makersmakingchange/Rumble-Plate-Dice-Roller/README.md

# Rumble Plate Dice Roller
A switch adapted device to roll the dice for any game night!

This switch activated dice roller utilizes a hobby motor, battery holder, Omron switch, and 3.5mm jack along with a couple 3d printed parts and a clear plastic cup to make any dice game more accessible. This device is a new development of the Dice Spinner that features faster dice rolling and variations in allowable cup size.

The Rumble Plate Dice Roller allows for approximately 10oz to 22oz clear plastic cups. Following the assembly guide, the components can be wired and mounted, then the dice roller is all ready to use! It is an easy toy to make that allows people to roll the dice in an alternative way.

## Usage

An AT switch can be plugged into the 3.5mm jack on the side of the device to be used for activation. Alternatively, the on-device switch can be used for activation. The on-device button would be meant more for others playing around the table who are able to reach over and wrap their hands around the base to push the button. With the additional print of the vertical push base, the on-device button can be used to turn the device itself into the activation button such that anyone around the table can push on to top of  the clear cup to roll the dice. This on-device button can be used in tandem with the corded AT switch.

## Required Skills:

 - Soldering
 - 3D Printing

## Required Components

 - Motor
 - AAA Battery Holder
 - Velcro
 - Omron Switch
 - 3.5mm Jack
 - Clear Plastic Cup
 - Dice
 - 3D Printed Parts

## Printing Instructions

- Print the STL files in their given orientations
- 0.3 mm Layer height
- No supports
- No brim

## Build Instructions

This device consists of several 3D printed components and electrical components that assemble together and can be used in tandem with an assistive switch. All STL’s and documentation can be found in the downloadable maker files in the GitHub Repository.

<!-- ABOUT MMC START -->
## About Makers Making Change
[Makers Making Change Logo](https://www.makersmakingchange.com/)

Makers Making Change is a program of [Neil Squire](https://www.neilsquire.ca/), a Canadian non-profit that uses technology, knowledge, and passion to empower people with disabilities.

Makers Making Change leverages the capacity of community based Makers, Disability Professionals and Volunteers to develop and deliver affordable Open Source Assistive Technologies.

 - Website: [www.MakersMakingChange.com](https://www.makersmakingchange.com/)
 - GitHub: [makersmakingchange](https://github.com/makersmakingchange)
 - Bluesky: [@makersmakingchange.bsky.social](https://bsky.app/profile/makersmakingchange.bsky.social)
 - Instagram: [@makersmakingchange](https://www.instagram.com/makersmakingchange)
 - Facebook: [makersmakechange](https://www.facebook.com/makersmakechange)
 - LinkedIn: [Neil Squire Society](https://www.linkedin.com/company/neil-squire-society/)
 - Thingiverse: [makersmakingchange](https://www.thingiverse.com/makersmakingchange/about)
 - Printables: [MakersMakingChange](https://www.printables.com/@MakersMakingChange)

### Contact Us
For technical questions, to get involved, or to share your experience we encourage you to [visit our website](https://www.makersmakingchange.com/) or [contact us](https://www.makersmakingchange.com/s/contact).
<!-- ABOUT MMC END -->
