makersmakingchange/Rumble-Plate-Dice-Roller/Documentation/Rumble_Plate_BOM.xlsx

Device: Rumble Plate Dice Tumbler |  |  |  |  |  | Total Cost | Total Print time (hr) | Total filament (g)
Version: V2.0 | Date Created: 9/14/2021 |  |  |  |  | $13.60 | 4.12 | 82.65
Commercial Parts:
Part type (Electrical. Mechanical, Sanitization, ect) | Part | Quantity Needed | Pkg Quantity | Price per package | Price per Unit | Price for qty needed |  | Link
Electrical | DC Motor | 1 | 1 | $2.66 | $2.66 | $2.66 |  | https://www.digikey.ca/en/products/detail/adafruit-industries-llc/711/5353610
Electrical | 3.5mm Mono Jack | 1 | 1 | $2.17 | $2.17 | $2.17 |  | https://www.digikey.ca/short/pq1d1z
Electrical | Switch (Omron B50503F-) | 1 | 1 | $0.94 | $0.94 | $0.94 |  | https://www.digikey.ca/short/jvzq2d
Electrical | Battery Holder | 1 | 1 | $1.69 | $1.69 | $1.69 |  | 2271 Kitronik Ltd. | Battery Products | DigiKey (https://www.digikey.ca/en/products/detail/kitronik-ltd/2271/8635436?productid=8635436)
Mechanical | Cup | 1 | 50 | $4.47 | $0.09 | $0.09 |  | https://www.walmart.ca/en/ip/great-value-plastic-party-cups-clear/6000198044907
Mechanical | Dice | 2 | 5 | $5.00 | $1.00 | $2.00 |  | https://www.walmart.ca/en/ip/ACE-Dice-5ct/PRD54IXGNXVYTJP
Electrical | AAA Batteries | 2 | 2 | $1.98 | $0.99 | $1.98 |  | https://www.walmart.ca/en/ip/energizer-max-alkaline-aaa-batteries-2-pack/PRD3IIHXYVK66QB
3D Printed Parts ESTIMATED PRICING USING 1KG ROLL COST: | $25.00
Part (estimated with 0.3 mm layer height) | Description | Quantity Needed | TOTAL Mass (g) | Estimated Price | Print Time (Min) | Link
Base | 3D printed Part | 1 | 42.85 | $1.07 | 124
Cam | 3D printed Part | 1 | 0.76 | $0.02 | 5
Retaining Ring | 3D printed Part | 1 | 7.86 | $0.20 | 22
Button | 3D printed Part | 1 | 1.03 | $0.03 | 5
Plate | 3D printed Part | 1 | 15.16 | $0.38 | 40
Lid | 3D printed Part | 1 | 14.99 | $0.37 | 51
 |  |  | Total Print Cost: | $2.07
Tools for Assembly
soldering iron
Pliers
Wire Cutters
Wire Strippers
Sharp Knife
Alternatives (if there are other sources for some parts link them below)
Part and description | Link
Cups | Free from a coffee shop/restaurant
DC Motor | Brushed DC Motor 2 (RM2) - RobotShop (https://www.robotshop.com/ca/en/solarbotics-regular-motor-2.html)
DC Motor (Bulk) | https://www.amazon.ca/Gikfun-Motor-Electric-Arduino-EK1291x10C/dp/B06WLL6QM5?hvadid=292968375828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
