makersmakingchange/Rumble-Plate-Dice-Roller/Build_Files/3D_Print_Files/Rumble_Plate_STLs/Rumble_Plate_Lid.stl

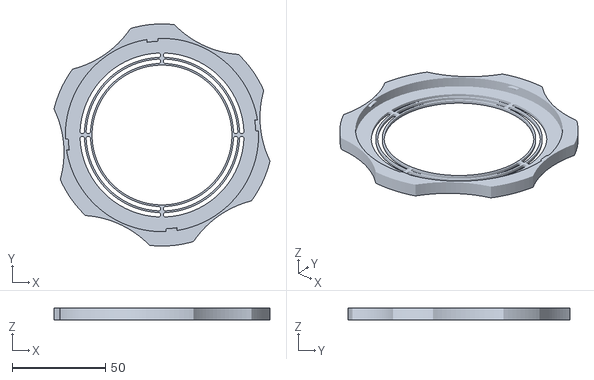
[picture p1: CAD file, 2021-11-09]
Build_Files/3D_Print_Files/Rumble_Plate_STLs/Rumble_Plate_Lid.stl
115.9 x 119.2 x 6.50
