makersmakingchange/Rumble-Plate-Dice-Roller/Build_Files/3D_Print_Files/Vertical_Push_Base_STLs/Vertical_Push_Base_top.stl

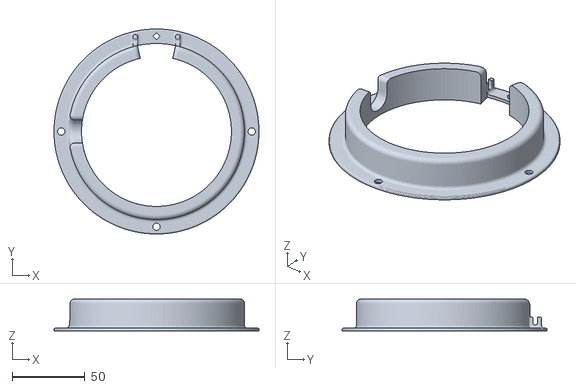
[picture p2: CAD file, 2021-12-02]
Build_Files/3D_Print_Files/Vertical_Push_Base_STLs/Vertical_Push_Base_top.stl
141.2 x 141.2 x 22.0
