makersmakingchange/Rumble-Plate-Dice-Roller/Rumble Plate STLs/Rumble Plate Base.stl

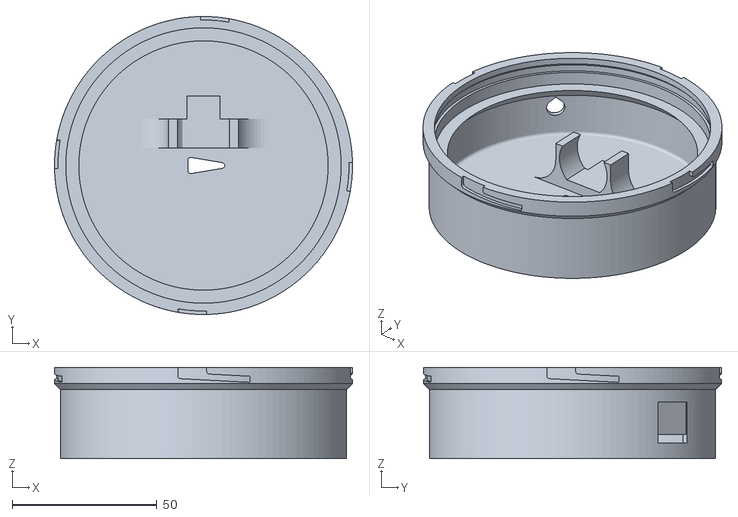
[picture p3: CAD file, 2021-11-09]
Rumble Plate STLs/Rumble Plate Base.stl
102.9 x 102.9 x 31.5
