makersmakingchange/Rumble-Plate-Dice-Roller/Vertical Push Base STLs/Vertical Push Base bottom.stl

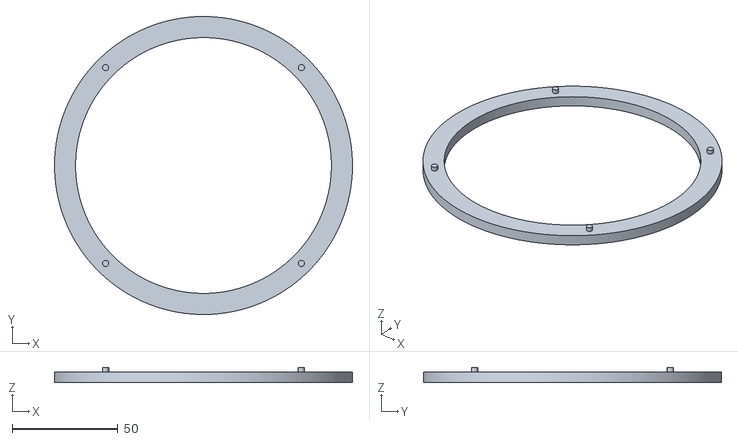
[picture p4: CAD file, 2021-11-09]
Vertical Push Base STLs/Vertical Push Base bottom.stl
141.2 x 141.2 x 7.00
