makersmakingchange/Rumble-Plate-Dice-Roller/Build_Files/3D_Print_Files/Rumble_Plate_STLs/Rumble_Plate_Retaining_Ring.stl

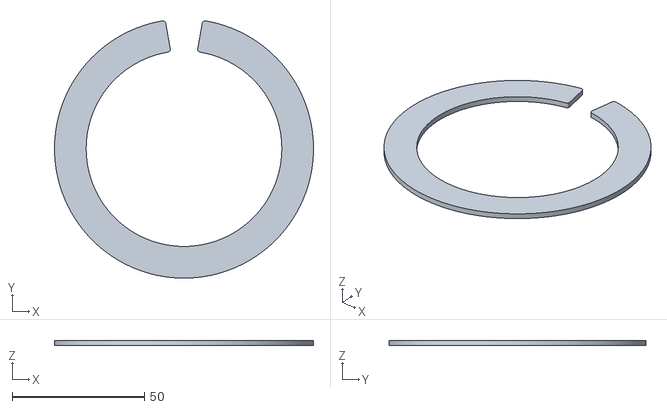
[picture p5: CAD file, 2021-11-09]
Build_Files/3D_Print_Files/Rumble_Plate_STLs/Rumble_Plate_Retaining_Ring.stl
98.0 x 97.3 x 2.00
