makersmakingchange/Rumble-Plate-Dice-Roller/Build_Files/3D_Print_Files/Vertical_Push_Base_STLs/Vertical_Push_Base_lever.stl

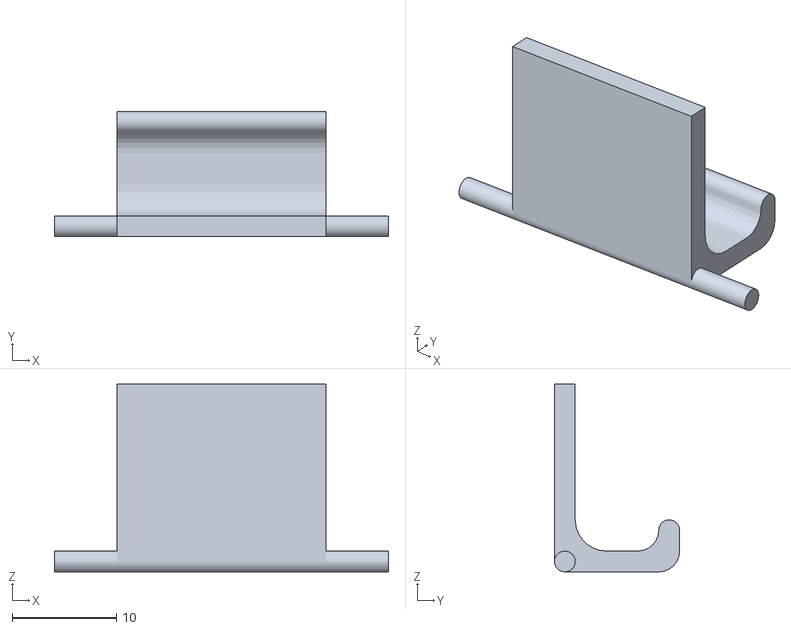
[picture p6: CAD file, 2021-12-02]
Build_Files/3D_Print_Files/Vertical_Push_Base_STLs/Vertical_Push_Base_lever.stl
32.0 x 12.0 x 18.0
