makersmakingchange/Rumble-Plate-Dice-Roller/Build_Files/3D_Print_Files/Rumble_Plate_STLs/Rumble_Plate_Cam.stl

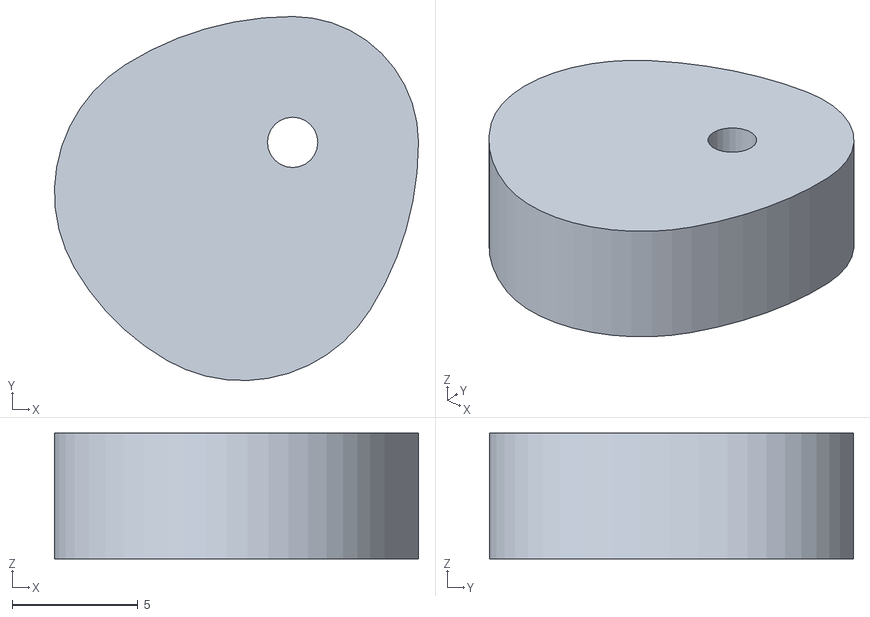
[picture p7: CAD file, 2021-11-09]
Build_Files/3D_Print_Files/Rumble_Plate_STLs/Rumble_Plate_Cam.stl
14.5 x 14.5 x 5.00
