makersmakingchange/Rumble-Plate-Dice-Roller/Build_Files/3D_Print_Files/Vertical_Push_Base_STLs/Vertical_Push_Base_flexure.stl

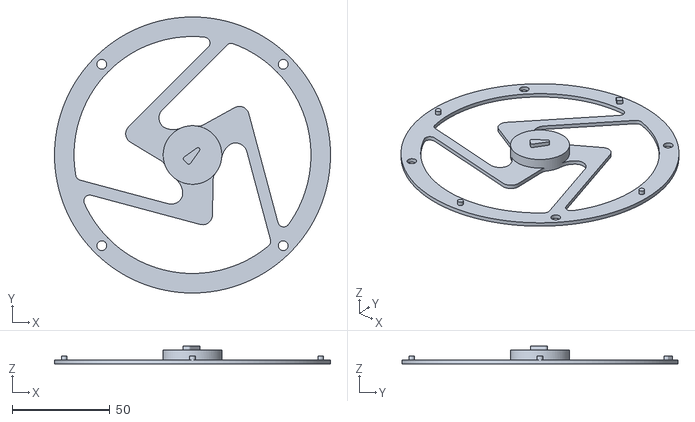
[picture p8: CAD file, 2021-11-09]
Build_Files/3D_Print_Files/Vertical_Push_Base_STLs/Vertical_Push_Base_flexure.stl
141.2 x 141.2 x 9.00
