makersmakingchange/Rumble-Plate-Dice-Roller/Build_Files/3D_Print_Files/Rumble_Plate_STLs/Rumble_Plate_Plate.stl

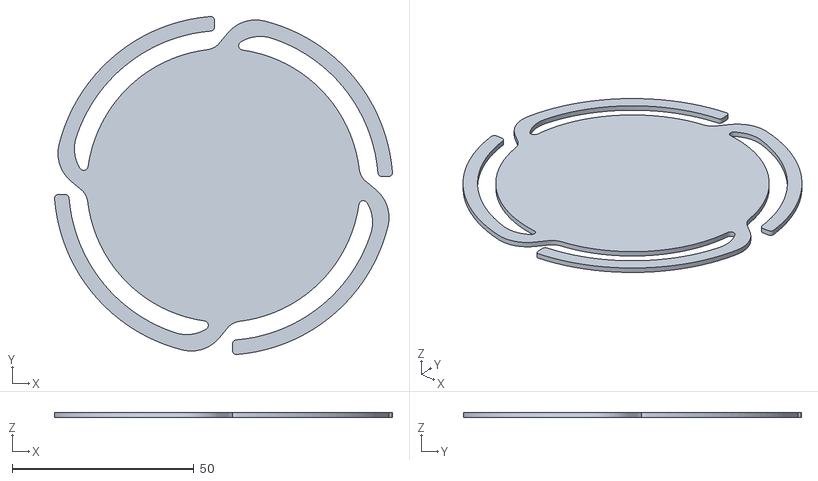
[picture p9: CAD file, 2021-11-09]
Build_Files/3D_Print_Files/Rumble_Plate_STLs/Rumble_Plate_Plate.stl
92.9 x 92.9 x 1.40
