makersmakingchange/Rumble-Plate-Dice-Roller/Build_Files/3D_Print_Files/Rumble_Plate_STLs/Rumble_Plate_Button.stl

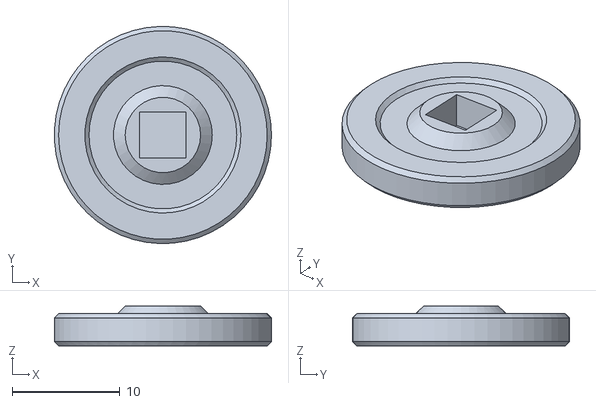
[picture p10: CAD file, 2021-11-09]
Build_Files/3D_Print_Files/Rumble_Plate_STLs/Rumble_Plate_Button.stl
20.1 x 20.1 x 3.70
