makersmakingchange/Rumble-Plate-Dice-Roller/(threads)

Thread 1 (2024-06-12):

Incorrect info on makers page and broken link in the printables page

MHache1717, 2024-06-12:
Our device page indicates it can be activated by pressing down on the cup. Unless I've missed something the current design doesn't support this function.

On the printables page there is a link to "see it in action". Link appears to be broken. Probably pre new website

https://makersmakingchange.com/wp-content/uploads/2021/11/DSCN0147.mov

jakemcivor, 2024-06-12:
I've updated the original website listing, removed the broken link from Printables, and created a separate issue to update the documentation for this device (e.g., User Guide, Design Rational, CAD Files).

The Rumble Plate Dice Roller can be activated by pushing down on the cup with the (optional) Vertical Push Base assembly. The Dice Roller is placed on/within the Push Base, which has a small hinge that pushes the button on the side when the Dice Roller is pushed down. We could use some additional images and a User Guide to make this clearer.

MHache1717, 2024-06-12:
Thanks. Didn't see any reference to the vertical push base but see the files on printables. If I get time next week I'll print it off and send some pictures

Closed 2024-06-12.

Thread 2 (2024-06-12):

Add CAD files

jakemcivor, 2024-06-12:
CAD files are missing

Thread 4 (2024-06-20):

More maker-friendly and reliable method for attaching button cap to tactile button

jakemcivor, 2024-06-20:
Sometimes using superglue to attach the button cap to the tactile switch can lead to the switch being stuck closed. The superglue may also not last over time.

Thread 7 (2025-04-30):

Dice don't always roll well / get stuck

jakemcivor, 2025-04-30:
Motor can be underpowered, and may have difficulty effectively rumbling/rolling the device.

Possible solutions: (via @derrickmmc )
1) Larger battery cells (e.g., AA, C, D) instead of AAA
2) Different motor
3) Add mosfet to circuit to avoid losing voltage through assistive switch/cable

jakemcivor, 2025-08-07:
Here are some other suggestions for mitigating this with the current design:

1. Check the 3D printed parts for defects/burrs that might tighten the plate down more than it should be.
1. Remove the retaining ring and see if that allows the motor to spin.
1. Check the motor is seated properly. If it sits too high or at an angle it will push against the plate too much.
1. Make sure the batteries are new.

1. Use smaller / lighter dice. There are some 3d printable options.

Thread 8 (2025-08-14):

Backwards threads

jakemcivor, 2025-08-14:
Threads to tighten the top are backwards (e.g., not right-tighty lefty-loosey)
